Kriegbaum/esp32s3-microsd-devkit/(commit log)

2023-07-23 Ready to make v0.1
    [esp32s3-microsd-devkit.kicad_pcb, usb_c.kicad_sch]
2023-08-03 Fix cross-wired USB lines
    [esp32s3-microsd-devkit.kicad_pcb, esp32s3-microsd-devkit.kicad_sch]
2023-08-04 Fix diode part number
    [usb_c.kicad_sch]
2023-08-10 Update diode reference
    [esp32s3-microsd-devkit.kicad_pcb]
